AhmedOmara708/Autonomous-Line-Following-Buggy/Planning/Combined EEE Gantt chart and risk register.pdf

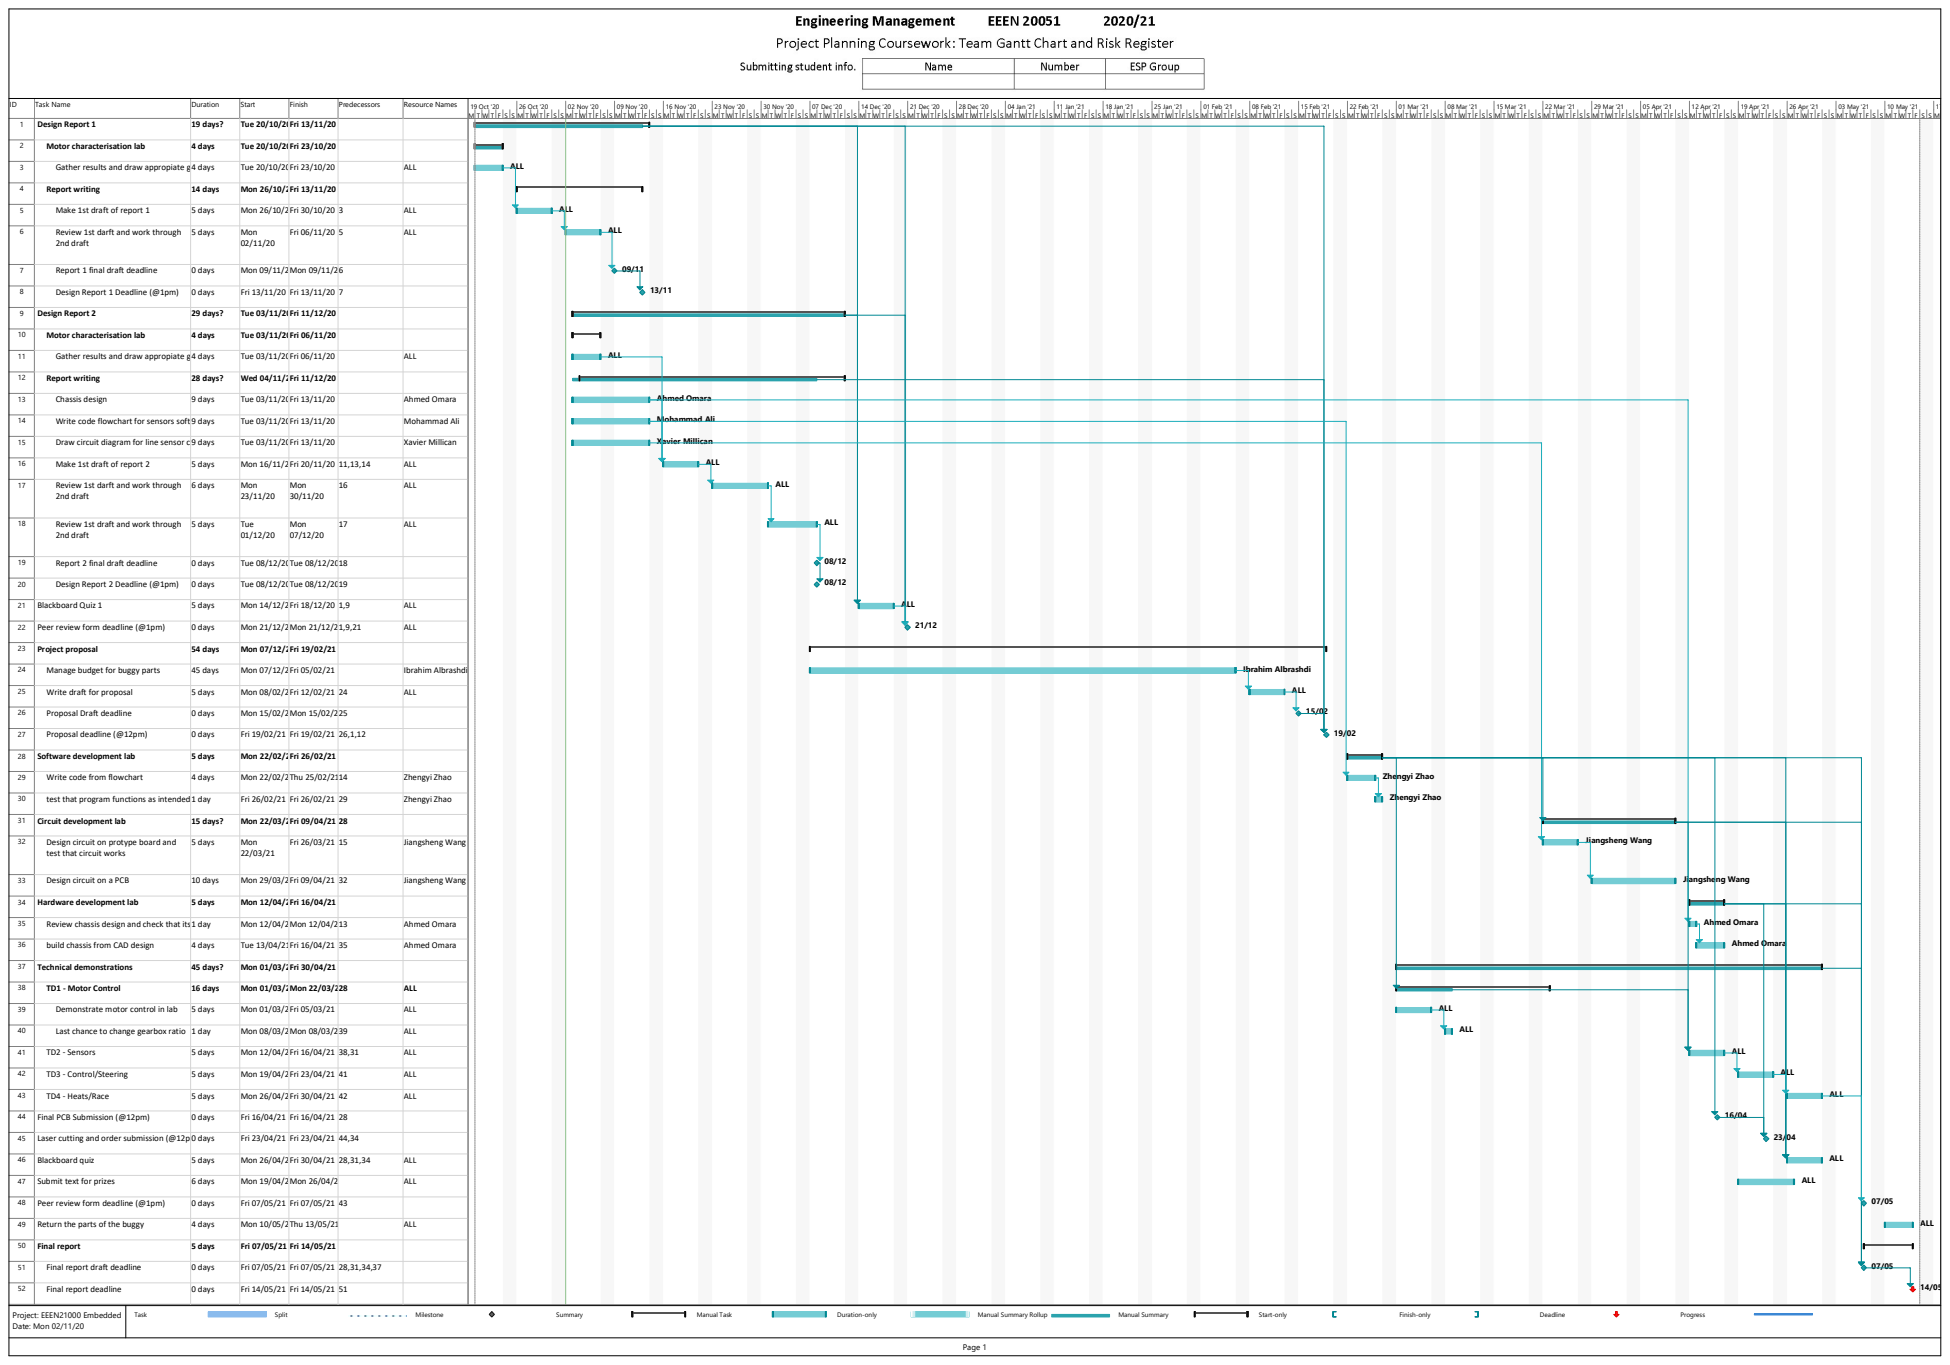
[picture p57: page 1]
ALL; 19 Oct '20; 26 Oct '20; 02 Nov '20; 09 Nov '20; 16 Nov '20; 23 Nov '20; 30 Nov '20; 07 Dec '20; 14 Dec '20; 21 Dec '20; 28 Dec '20; 04 Jan '21; 11 Jan '21; 18 Jan '21; 25 Jan '21; 01 Feb '21; 08 Feb '21; 15 Feb '21; 22 Feb '21; 01 Mar '21; 08 Mar '21; 15 Mar '21; 22 Mar '21; 29 Mar '21; 05 Apr '21; 12 Apr '21; 19 Apr '21; 26 Apr '21; 03 May '21; 10 May '21; 17 May '21; Page 1

ID | Task Name | Duration | Start | Finish | Predecessors | Resource Names | M T W T F S S M T W T F S S M T W T F S S M T W T F S S M T W T F S S M T W T F S S M T W T F S S M T W T F S S M T W T F S S M T W T F S S M T W T F S S M T W T F S S M T W T F S S M T W T F S S M T W T F S S M T W T F S S M T W T F S S M T W T F S S M T W T F S S M T W T F S S M T W T F S S M T W T F S S M T W T F S S M T W T F S S M T W T F S S M T W T F S S M T W T F S S M T W T F S S M T W T F S S M T W T F S S M
1 | Design Report 1 | 19 days? | Tue 20/10/20Fri 13/11/20

2 | Motor characterisation lab | 4 days | Tue 20/10/20Fri 23/10/20

3 | Gather results and draw appropiate graphs 4 days | | Tue 20/10/20Fri 23/10/20 | | | ALL

ALL | 13/11

4 | Report writing | 14 days | Mon 26/10/20Fri 13/11/20

5 | Make 1st draft of report 1 | 5 days | Mon 26/10/20Fri 30/10/20 | | 3 | ALL

ALL | ALL | 09/11

6 Review 1st darft and work through | 2nd draft | 5 days | Mon 02/11/20 | Fri 06/11/20 | 5 | ALL

7 | Report 1 final draft deadline | 0 days | Mon 09/11/20Mon 09/11/206

8 | Design Report 1 Deadline (@1pm) | 0 days | Fri 13/11/20 | Fri 13/11/20 | 7

9 | Design Report 2 | 29 days? | Tue 03/11/20Fri 11/12/20

10 | Motor characterisation lab | 4 days | Tue 03/11/20Fri 06/11/20

11 | Gather results and draw appropiate graphs 4 days | | Tue 03/11/20Fri 06/11/20 | | | ALL

ALL

12 | Report writing | 28 days? | Wed 04/11/20Fri 11/12/20

13 | Chassis design | 9 days | Tue 03/11/20Fri 13/11/20 | | | Ahmed Omara

Ahmed Omara

14 | Write code flowchart for sensors software 9 days | | Tue 03/11/20Fri 13/11/20 | | | Mohammad Ali

Mohammad Ali

15 | Draw circuit diagram for line sensor circuit 9 days | | Tue 03/11/20Fri 13/11/20 | | | Xavier Millican

Xavier Millican

16 | Make 1st draft of report 2 | 5 days | Mon 16/11/20Fri 20/11/20 | | 11,13,14 | ALL

ALL | | ALL | ALL | ALL | 21/12

17 Review 1st darft and work through | 2nd draft | 6 days | Mon 23/11/20 | Mon 30/11/20 | 16 ALL

18 Review 1st draft and work through | 2nd draft | 5 days | Tue 01/12/20 | Mon 07/12/20 | 17 ALL

19 | Report 2 final draft deadline | 0 days | Tue 08/12/20Tue 08/12/2018

20 | Design Report 2 Deadline (@1pm) | 0 days | Tue 08/12/20Tue 08/12/2019

21 | Blackboard Quiz 1 | 5 days | Mon 14/12/20Fri 18/12/20 | | 1,9 | ALL

22 | Peer review form deadline (@1pm) | 0 days | Mon 21/12/20Mon 21/12/201,9,21 | | | ALL

23 | Project proposal | 54 days | Mon 07/12/20Fri 19/02/21 | | | | | | | | | | | | Ibrahim Albrashdi | ALL | 15/02

24 | Manage budget for buggy parts | 45 days | Mon 07/12/20Fri 05/02/21 | | | Ibrahim Albrashdi

25 | Write draft for proposal | 5 days | Mon 08/02/21Fri 12/02/21 | | 24 | ALL

26 | Proposal Draft deadline | 0 days | Mon 15/02/21Mon 15/02/2125

27 | Proposal deadline (@12pm) | 0 days | Fri 19/02/21 | Fri 19/02/21 | 26,1,12

28 | Software development lab | 5 days | Mon 22/02/21Fri 26/02/21

29 | Write code from flowchart | 4 days | Mon 22/02/21Thu 25/02/2114 | | | Zhengyi Zhao

Zhengyi Zhao

30 | test that program functions as intended1 day | | Fri 26/02/21 | Fri 26/02/21 | 29 | Zhengyi Zhao

31 | Circuit development lab | 15 days? | Mon 22/03/21Fri 09/04/21 28

32 Design circuit on protype board and | test that circuit works | 5 days | Mon 22/03/21 | Fri 26/03/21 | 15 | Jiangsheng Wang

Jiangsheng Wang | Jiangsheng Wang

33 | Design circuit on a PCB | 10 days | Mon 29/03/21Fri 09/04/21 | | 32 | Jiangsheng Wang

34 | Hardware development lab | 5 days | Mon 12/04/21Fri 16/04/21

35 | Review chassis design and check that its fine 1 day | | Mon 12/04/21Mon 12/04/213 | | | Ahmed Omara

Ahmed Omara | Ahmed Omara

36 | build chassis from CAD design | 4 days | Tue 13/04/21Fri 16/04/21 | | 35 | Ahmed Omara

37 | Technical demonstrations | 45 days? | Mon 01/03/21Fri 30/04/21

38 | TD1 - Motor Control | 16 days | Mon 01/03/21Mon 22/03/2128 | | | ALL

39 | Demonstrate motor control in lab | 5 days | Mon 01/03/21Fri 05/03/21 | | | ALL

ALL | ALL

40 | Last chance to change gearbox ratio | 1 day | Mon 08/03/21Mon 08/03/2139 | | | ALL

41 | TD2 - Sensors | 5 days | Mon 12/04/21Fri 16/04/21 | | 38,31 | ALL

ALL | | ALL | ALL

42 | TD3 - Control/Steering | 5 days | Mon 19/04/21Fri 23/04/21 | | 41 | ALL

43 | TD4 - Heats/Race | 5 days | Mon 26/04/21Fri 30/04/21 | | 42 | ALL

44 | Final PCB Submission (@12pm) | 0 days | Fri 16/04/21 | Fri 16/04/21 | 28

45 | Laser cutting and order submission (@12pm) 0 days | | Fri 23/04/21 | Fri 23/04/21 | 44,34

46 | Blackboard quiz | 5 days | Mon 26/04/21Fri 30/04/21 | | 28,31,34 | ALL

47 | Submit text for prizes | 6 days | Mon 19/04/21Mon 26/04/21 | | | ALL

48 | Peer review form deadline (@1pm) | 0 days | Fri 07/05/21 | Fri 07/05/21 | 43

49 | Return the parts of the buggy | 4 days | Mon 10/05/21Thu 13/05/21 | | | ALL

50 | Final report | 5 days | Fri 07/05/21 Fri 14/05/21 | | | | | | | | | | | | | | | | | 07/05

51 | Final report draft deadline | 0 days | Fri 07/05/21 | Fri 07/05/21 | 28,31,34,37

52 | Final report deadline | 0 days | Fri 14/05/21 | Fri 14/05/21 | 51

Project: EEEN21000 Embedded Date: Mon 02/11/20 | Task Split Milestone Summary Manual Task Duration-only Manual Summary Rollup Manual Summary Start-only Finish-only Deadline Progress

# RISK REGISTER FOR EMBEDDED SYSTEMS PROJECT

Group Number: | 1 | Submission Date: | 05/11/2020
Group Members: | Ahmed Omara | Xavier Millican | Ibrahim Albrashdi | Mohammad Ali | Zhao Zhengyi | Wang Jiangsheng

We confirm that all group members participated in the production of this risk register: Yes

Project Risk | Severity | Potential | Score (Severity x Potential) | Mitigation Measures | Owner
L | M | H | L | M | H | L=1, M=2, H=3
Water damage to circuit | | | | | | | 6 | Have no liquids near the electronics | Student
Overload motor with high current, causing motor to overheat | | | | | | | 2 | Limit the current to the motor | Student
Fumes while soldering | | | | | | | 6 | Have a proper ventilation while soldering | Student
Tripping over obstacles in the lab | | | | | | | 2 | Remove obstacles from walking path | Student
Damaging buggy by dropping it | | | | | | | 2 | Handle buggy carefully | Student
Delay in ordering parts | | | | | | | 4 | Order parts early | University of Manchester
Risk of contracting coronavirus | | | | | | | 3 | Practice social distancing and wear face covering | Environment
Faulty motor | | | | | | | 2 | Learn skills when they are needed | University of Manchester
Lack of skills/knowledge | | | | | | | 2 | Research more | Student
Weather on test day affecting test | | | | | | | 1 | Check forecast | Environment
Limit in resources | | | | | | | 2 | Collect resources prior to building | University of Manchester
Lack of communication | | | | | | | 3 | Attempt to communicate well as a team - bonding | Student
Collision of the buggy with another buggy | | | | | | | 1 | Do not simultaneously race buggies | Student
Improper construction of buggy | | | | | | | 2 | Check buggy works well and test | Student
Burns from soldering iron | | | | | | | 4 | Don’t hold the soldering iron tip and wear gloves | Student
